Zhuravl/Watering_station/Docs/Documentation.xlsx

Sheet: Readme
Общая информация:
Оригинальный Arduino UNO R3 |  |  |  |  |  |  |  |  |  |  |  |  |  |  |  | http://www.kosmodrom.com.ua/el.php?name=ARDUINO-UNO-R3-WZE
Драйвер для USB-платы |  |  |  |  |  |  |  |  |  |  |  |  |  |  |  | http://www.arduined.eu/ch340-windows-8-driver-download/
Сайт с хорошим описанием |  |  |  |  |  |  |  |  |  |  |  |  |  |  |  | http://arduino.ru
Принцип работы:
Прибор включает нагрузку (электронасос) два раза в сутки, в заданное время. Продолжительность работы настраивается одним параметром для обоих случаев включения.
Прибор производит контроль наличия осадков (внешний датчик) за два часа, за час и непосредственно перед включением полива. Если датчик покажет что в один из моментов был дождь, ближайший полив будет пропущен.
Есть возможность корректировать текущую дату и время, время и продолжительность полива. В случае отсутствия питания в сети, полив будет пропущен, но текущая дата и время поливов не собъются. Индикация будет возобновлена после возобновления питания из сети.
1 | 9 | . | 1 | 1 | . | 2 | 0 | 1 | 9 |  | 1 | 9 | : | 0 | 5 | Режим ожидания. Индикация текущей даты, времени ближайшего полива и времени до его начала.
W | 1 | 9 | : | 3 | 0 |  | - | > |  | - | 0 | 3 | : | 1 | 9
1 | 9 | . | 1 | 1 | . | 2 | 0 | 1 | 9 |  | 1 | 9 | : | 0 | 5 | Режим полива. Индикация текущей даты и времени начала и конца полива.
* | * | 1 | 9 | : | 3 | 0 | - | - | 2 | 0 | : | 0 | 0 | * | *
1 | 9 | . | 1 | 1 | . | 2 | 0 | 1 | 9 |  | 1 | 9 | : | 0 | 5 | Режим ожидания. Индикация текущей даты, информирование о пропуске ближайшего полива, из-за дождя.
W | 1 | 9 | : | 3 | 0 |  |  | L | L |  | S | K | I | P
< |  |  | W | . |  | H | O | U | R | S |  | 1 |  |  | >
 |  |  |  |  |  | 2 | 0
< |  | W | . |  | M | I | N | U | T | E | S |  | 1 |  | >
< |  | W | . | D | U | R | A | T | I | O | N |  | 1 |  | >
 |  |  |  |  |  | 3 | 0
* | F | O | R | S | E |  | W | A | T | E | R | I | N | G | *

Sheet: Pinouts
Clock: |  | Display with buttons:
RTC DS1302 | Arduino UNO | LCD1602KEYPAD | Arduino UNO |  |  |  | RTC GND | Water sensor PWR | Relay IN |  | LCD screen data | LCD screen data | LCD screen data | LCD screen data | LCD screen data | LCD screen data | RTC data | RTC data | RTC data
VCC | 3,3V | RST | RST
GND | GND | 5V | +5V
CLK (SCLK) | D4 | GND | GND
DAT (I/O) | D3 | A0 | A0
RST (CE) | D2 | D4 | D5
 |  | D5 | D6 | SCL | SDA | AREF | GND | D13 | D12 | ~D11 | ~D10 | ~D9 | D8 | D7 | ~D6 | ~D5 | D4 | ~D3 | D2 | TX->D1 | RX->D0
Rellay: |  | D6 | D7
1CH5VRMA | Arduino UNO | D7 | D8 | ARDUINO UNO R3 [CH340/ATmega328P] |  |  |  |  |  |  |  |  |  |  |  |  |  |  |  | ISCP | ISCP
VCC | 5V | D8 | D9 |  |  |  |  |  |  |  |  |  |  |  |  |  |  |  |  | ISCP | ISCP
GND | GND | D9 | D10 |  |  |  |  |  |  |  |  |  |  |  |  |  |  |  |  | ISCP | ISCP
IN | D12
NO | ~220V out | Rain sensor: |  |  |  |  |  |  |  |  |  |  |  |  |  |  |  | RX | TX | 5V | GND
COM | ~220V in | T1592-MODUL | Arduino UNO |  |  |  |  |  |  |  |  |  |  |  |  |  |  | SCL | SDA | 5V | GND
NC | - | + | D13 |  |  |  |  |  |  |  |  |  |  |  |  |  |  | 3,3V | 3,3V | GND | GND
 |  | - | GND
 |  | S | A5 |  |  |  |  | 5V | RESET | 3,3V | 5V | GND | GND | Vin |  | A0 | A1 | A2 | A3 | A4 | A5
 |  |  |  |  |  |  |  | LCD power +5V | LCD buttons reset | RTC PWR | Relay PWR | Relay GND | LCD GND |  |  | LCD buttons data |  |  |  |  | Water sensor data

Sheet: Costs
Costs
№ | Name | Price, UAH | Link
1 | Arduino UNO R3 [CH340/ ATmega328P] | 115.75 | http://www.kosmodrom.com.ua/el.php?name=ARDUINO-UNO-R3-MEGA328P
2 | Power supply for Arduino UNO (OV-A002 9V/1A) | 84.00 | https://www.rcscomponents.kiev.ua/product/ov-a002-9v-1a_67292.html
3 | 5V Rellay for Arduino | 17.50 | http://www.kosmodrom.com.ua/el.php?name=1CH5VRMA
4 | Real Time Clock | 17.25 | http://www.kosmodrom.com.ua/el.php?name=DS1302-MOD
5 | Rain sensor | 6.25 | http://www.kosmodrom.com.ua/el.php?name=T1592-MODUL
6 | LCD Keypad Shield | 100.75 | http://www.kosmodrom.com.ua/el.php?name=LCD1602KEYPAD
7 | Jumpers FM (40шт) | 23.25 | http://www.kosmodrom.com.ua/el.php?name=JUMPERS-FM-100MM
8 | Device body | 95.00 | https://www.rcscomponents.kiev.ua/product/21-12-47-sanhe-korpus-plastik-140x82x23mm_36265.html
 | TOTAL PRICE: | 459.75
