Zhuravl/Watering_station/(commit log)

2017-12-10 Added logic for buttons
2017-12-11 Added readme file
    [Documentation.xlsx]
2017-12-14 Added watering logic
    [Documentation.xlsx]
2017-12-14 Added reseting for rain data
    [WateringStationSketch.ino]
2017-12-14 Fixed mistake in logic
    [WateringStationSketch.ino]
2017-12-18 Added skip rain method
    [WateringStationSketch.ino]
2017-12-20 Fix control signal for P-N-P relay
    [WateringStationSketch.ino]
2017-12-20 Changed pinouts
    [Documentation.xlsx]
2018-05-31 Supported new relay
2018-06-11 Fix wrong next watering time calculation
    [WateringStationSketch.ino]
2018-06-18 Added device final view
